akhleif-pixel/fly-brain-drone/docs/drone-3d-revb/pcb-bottom.png

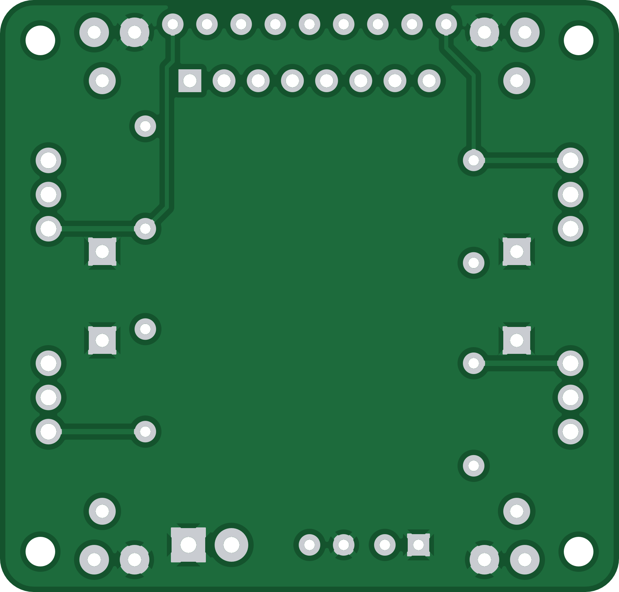
docs/drone-3d-revb/pcb-bottom.png
