akhleif-pixel/fly-brain-drone/docs/drone-3d-revb/pcb-top.png

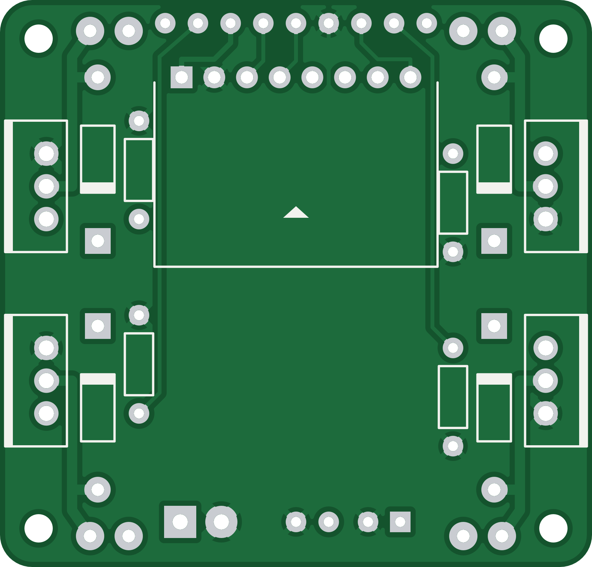
docs/drone-3d-revb/pcb-top.png
