akhleif-pixel/fly-brain-drone/pcb/fc/out/render-angle.png

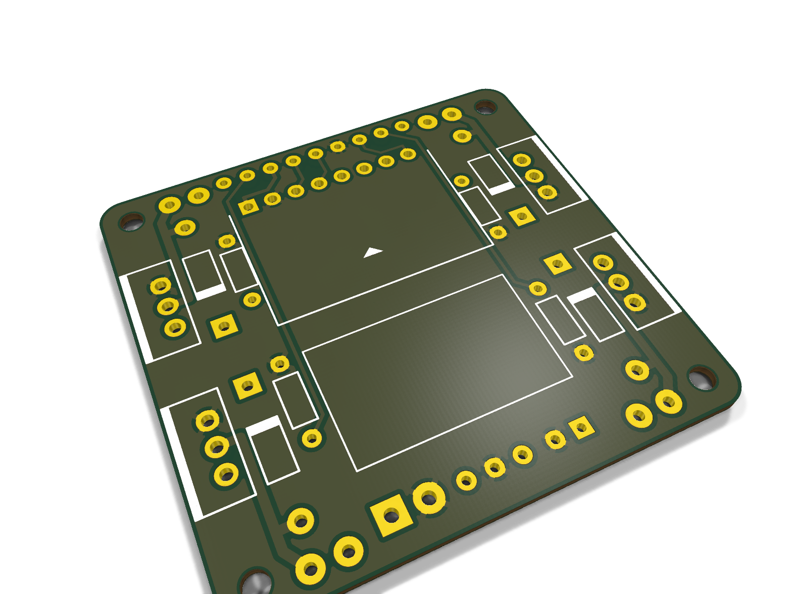
pcb/fc/out/render-angle.png
