akhleif-pixel/fly-brain-drone/pcb/fc/out/render-bottom.png

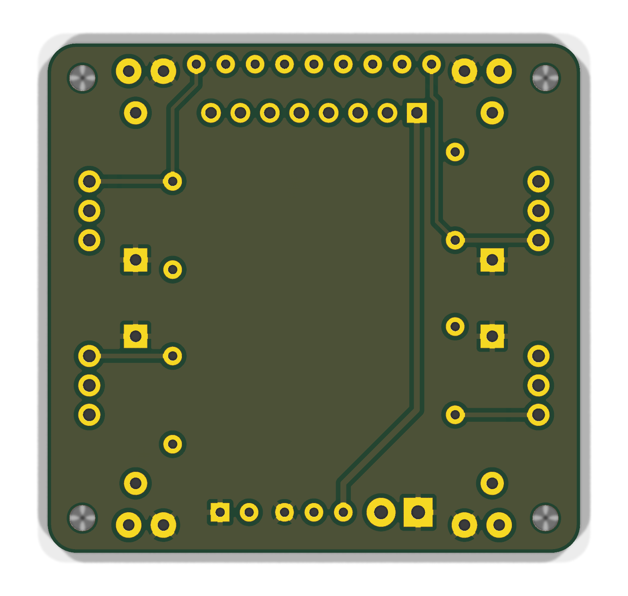
pcb/fc/out/render-bottom.png
