akhleif-pixel/fly-brain-drone/pcb/fc/out/render-top.png

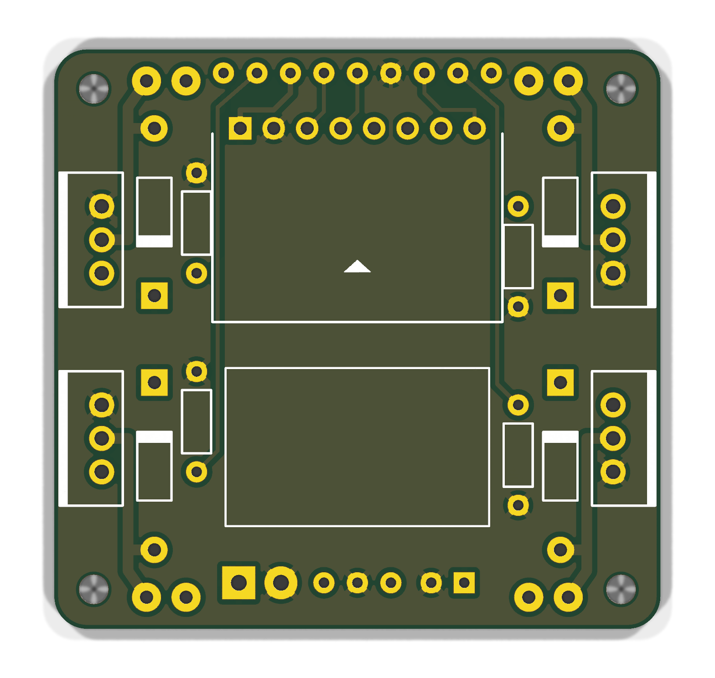
pcb/fc/out/render-top.png
