akhleif-pixel/fly-brain-drone/pcb/out/kicad-render-bottom.png

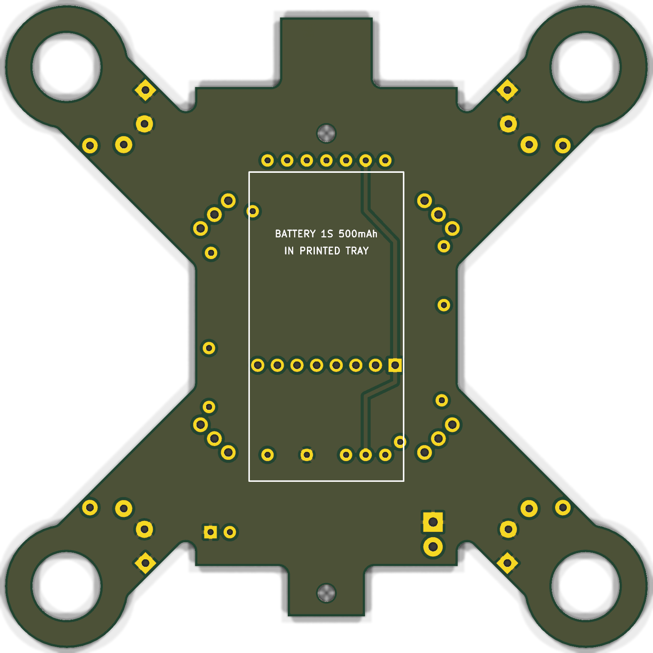
pcb/out/kicad-render-bottom.png
