akhleif-pixel/fly-brain-drone/pcb/out/kicad-render-top.png

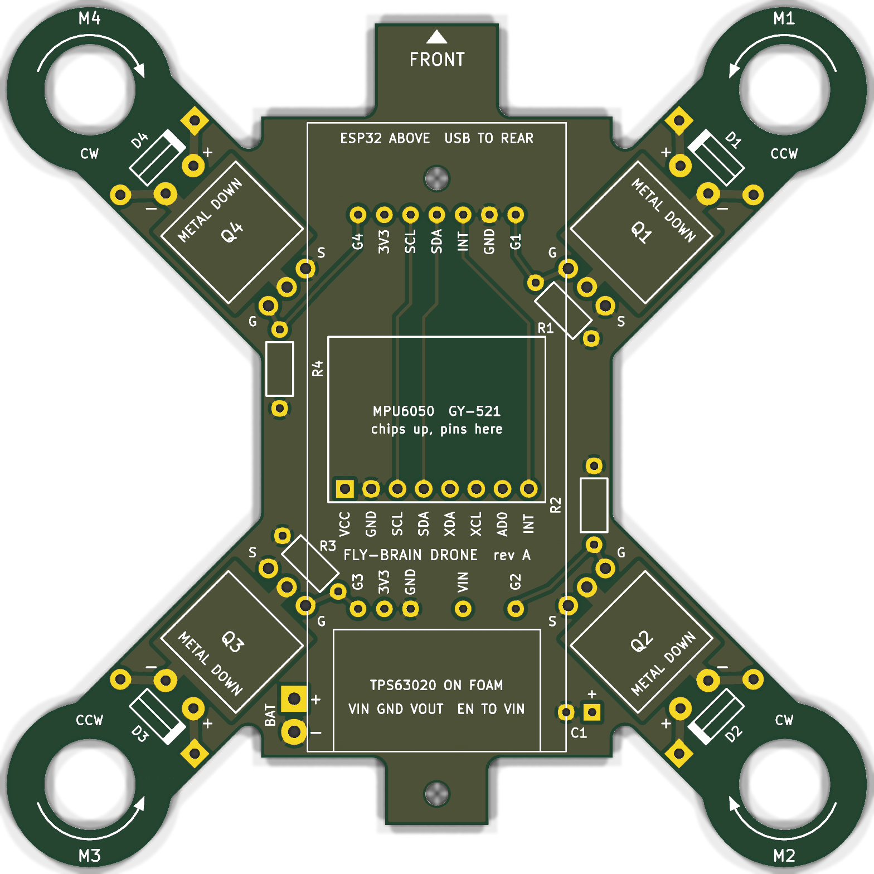
pcb/out/kicad-render-top.png
