akhleif-pixel/fly-brain-drone/pcb/out/preview-bottom.png

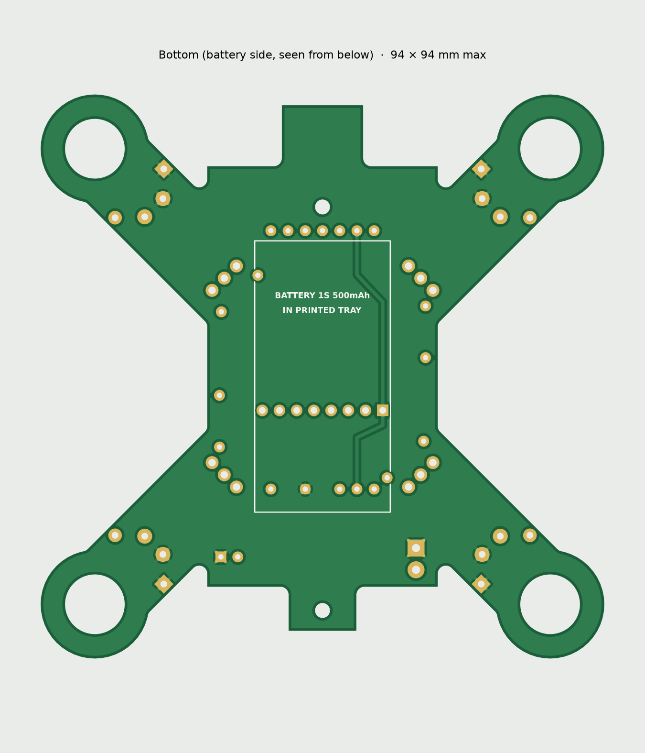
pcb/out/preview-bottom.png
