akhleif-pixel/fly-brain-drone/docs/parts.md

# Parts

AliExpress cart, October 5, 2026: 13 items, $43.31, free shipping, expected October 13–18. Photos and links: https://claude.ai/artifact/14MLLZMBsPiJeyRGL1XqSZ

| Part | Price | Use | Notes |
| --- | --- | --- | --- |
| ESP32-S3 CAM board (N16R8), board only | $6.20 | 1 | Onboard computer |
| OV2640 camera, 66°, 21 mm cable | $4.62 | 1 | The fly's eye |
| GY-521 MPU6050 | $1.82 | 1 | Balance sensor |
| 8520 coreless motors, 2 CW + 2 CCW | $8.74 | 4 | Flight motors |
| 55 mm props + 4 spare 716 motors | $4.06 | 4 props | Spares for bench tests |
| 3.7 V 500 mAh battery | $5.83 | 1 | 3–5 min flight |
| TPS63020 buck-boost, 3.3 V | $1.99 | 1 | Steady 3.3 V |
| 100 µF 16 V capacitors ×20 | $1.85 | 1–2 | Across battery |
| IRLB8721 MOSFETs ×10 | $2.96 | 4 | Motor switches |
| 1N5819 Schottky diodes ×50 | $1.32 | 4 | Flyback protection |
| 10 kΩ resistors ×100 | $1.14 | 4 | Gate pull-downs |
| 28 AWG silicone wire, red, 3 m | $1.43 | ~1 m | |
| Perfboard 4 × 6 cm ×5 | $1.85 | 1 | Motor driver board |

Measured from photos with a ruler (2026-10-26): ESP32 board about 28.5 × 51 mm plus a 7 mm antenna overhang; TPS63020 module about 27.5 × 18.7 mm; IRLB8721 about 10.5 × 16.6 mm (genuine IR); motors about 8.3 × 20 mm; battery about 40 × 24 mm with a small white 2-pin plug.

Already owned: battery charger (check charge current ≤500 mA), 25 V 100 µF capacitors, 1N4002 diodes (bench tests only — too slow for 20 kHz PWM), soldering iron, 3D printing.
