akhleif-pixel/fly-brain-drone/docs/parts-page/img/batt.jpg

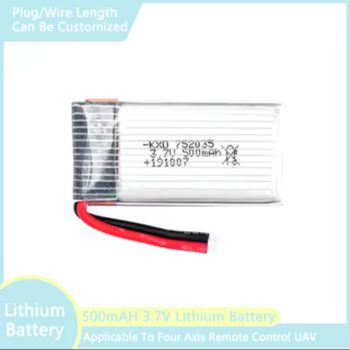
docs/parts-page/img/batt.jpg
