akhleif-pixel/fly-brain-drone/docs/parts-page/img/cam.jpg

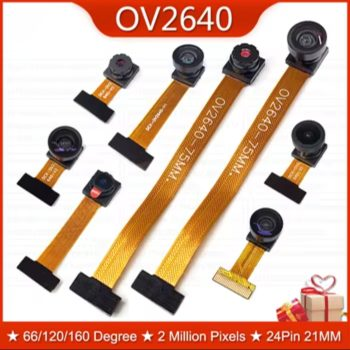
docs/parts-page/img/cam.jpg
