akhleif-pixel/fly-brain-drone/docs/parts-page/img/cap.jpg

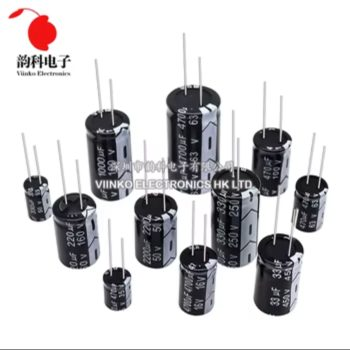
docs/parts-page/img/cap.jpg
