akhleif-pixel/fly-brain-drone/docs/parts-page/img/diode.jpg

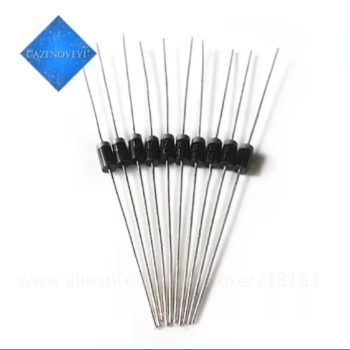
docs/parts-page/img/diode.jpg
