akhleif-pixel/fly-brain-drone/docs/parts-page/img/esp.jpg

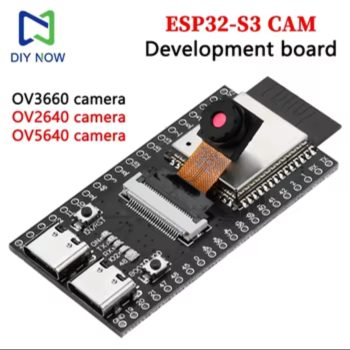
docs/parts-page/img/esp.jpg
