akhleif-pixel/fly-brain-drone/docs/parts-page/img/irlb.jpg

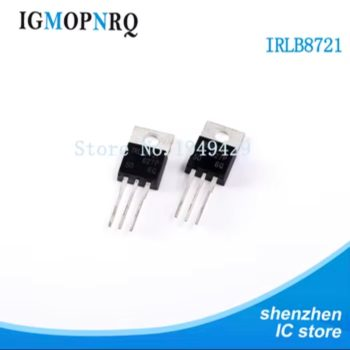
docs/parts-page/img/irlb.jpg
