akhleif-pixel/fly-brain-drone/docs/parts-page/img/m8520.jpg

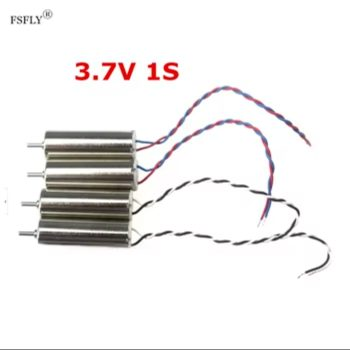
docs/parts-page/img/m8520.jpg
