akhleif-pixel/fly-brain-drone/docs/parts-page/img/mpu.jpg

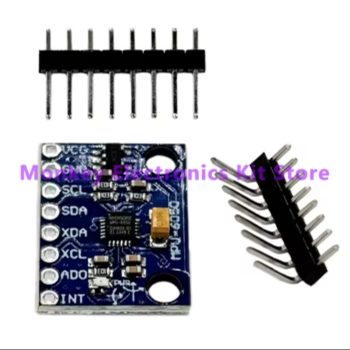
docs/parts-page/img/mpu.jpg
