akhleif-pixel/fly-brain-drone/docs/parts-page/img/perf.jpg

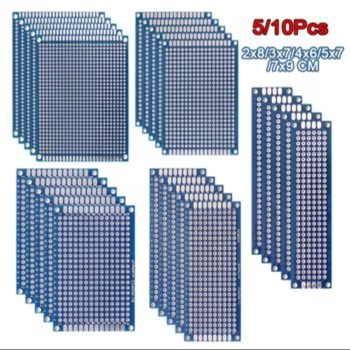
docs/parts-page/img/perf.jpg
