akhleif-pixel/fly-brain-drone/docs/parts-page/img/props.jpg

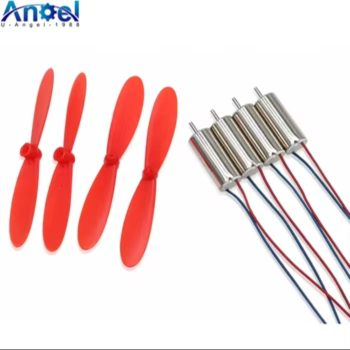
docs/parts-page/img/props.jpg
