akhleif-pixel/fly-brain-drone/docs/parts-page/img/res.jpg

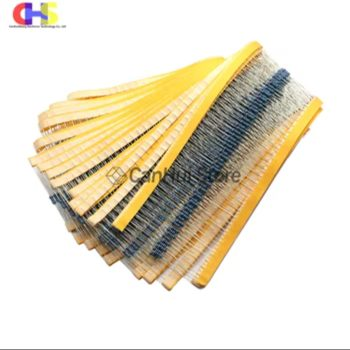
docs/parts-page/img/res.jpg
