akhleif-pixel/fly-brain-drone/docs/parts-page/img/tps.jpg

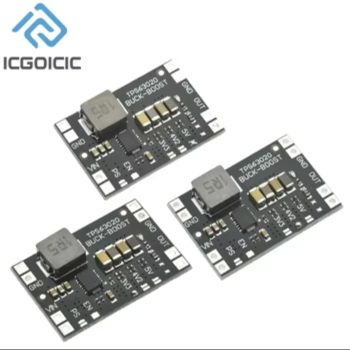
docs/parts-page/img/tps.jpg
