akhleif-pixel/fly-brain-drone/docs/parts-page/img/wire.jpg

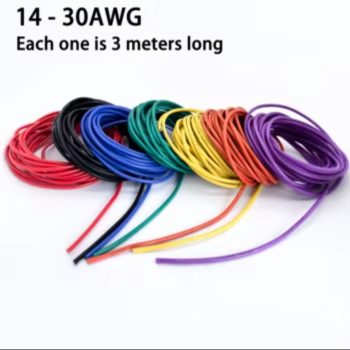
docs/parts-page/img/wire.jpg
