akhleif-pixel/fly-brain-drone/frame/out/frame.stl

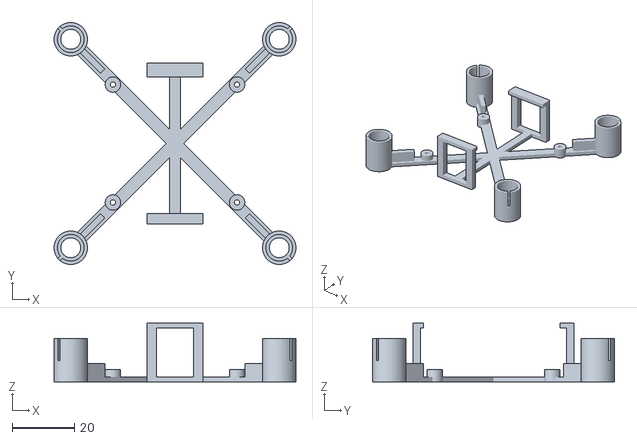
[picture p26: CAD file, 2026-10-27]
frame/out/frame.stl
78.0 x 78.0 x 19.0
