akhleif-pixel/fly-brain-drone/pcb/fc/kicad/fly-fc.kicad_pcb

## KiCad design pcb/fc/kicad/fly-fc.kicad_pcb (2026-10-27)

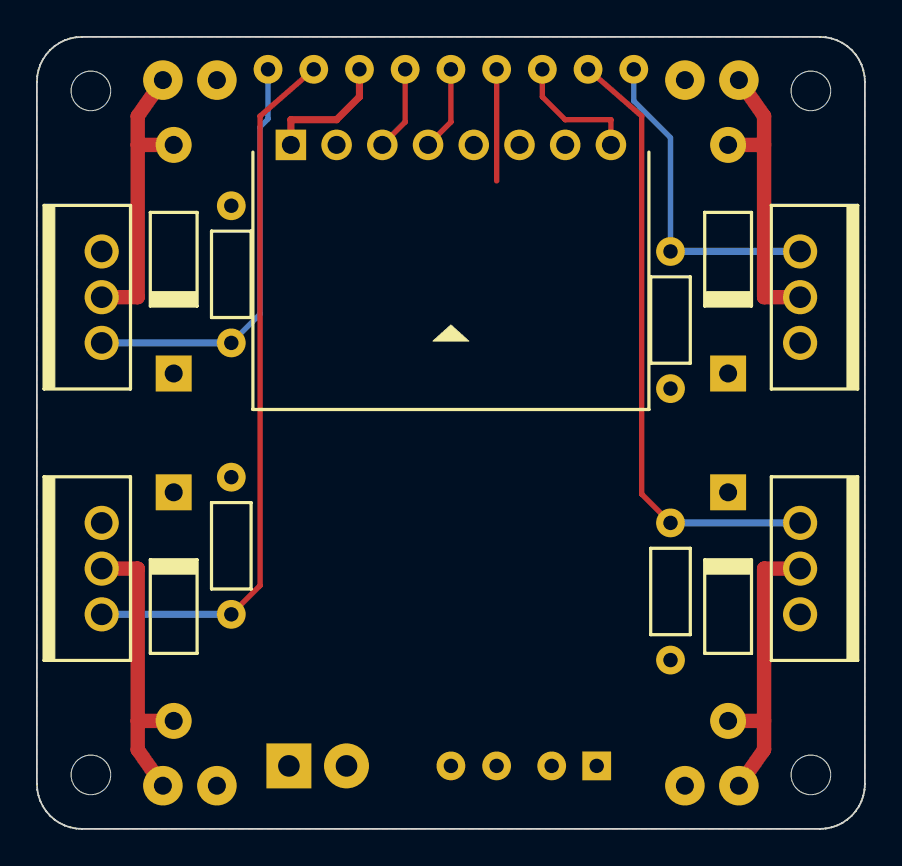
[picture p27: board fly-fc.kicad_pcb from above]

Board: 2 copper layers, 46.0 x 44.0 mm, 34 parts (0 on the bottom side), 14 nets.

Parts:
BAT: battery pigtail; BAT
C1: 100uF; C1
D1: 1N5819; D1
D2: 1N5819; D2
D3: 1N5819; D3
D4: 1N5819; D4
H1, H2, H3, H4: M2; MountingHole_M2
J_3V3: wire pad; J_3V3
J_G1: wire pad; J_G1
J_G2: wire pad; J_G2
J_G3: wire pad; J_G3
J_G4: wire pad; J_G4
J_GND: wire pad; J_GND
J_IN: wire pad; J_IN
J_INT: wire pad; J_INT
J_SCL: wire pad; J_SCL
J_SDA: wire pad; J_SDA
J_TG: wire pad; J_TG
M1: 8520 motor; M1
M2: 8520 motor; M2
M3: 8520 motor; M3
M4: 8520 motor; M4
Q1: IRLB8721; Q1
Q2: IRLB8721; Q2
Q3: IRLB8721; Q3
Q4: IRLB8721; Q4
R1: 10k; R1
R2: 10k; R2
R3: 10k; R3
R4: 10k; R4
U2: GY-521 MPU6050; U2

Connections:
3V3: J_3V3.1, U2.VCC
DRAIN1: D1.A, M1.2, Q1.D
DRAIN2: D2.A, M2.2, Q2.D
DRAIN3: D3.A, M3.2, Q3.D
DRAIN4: D4.A, M4.2, Q4.D
GATE1: J_G1.1, Q1.G, R1.1
GATE2: J_G2.1, Q2.G, R2.1
GATE3: J_G3.1, Q3.G, R3.1
GATE4: J_G4.1, Q4.G, R4.1
GND: BAT.2, C1.2, J_GND.1, J_TG.1, Q1.S, Q2.S, Q3.S, Q4.S, R1.2, R2.2, R3.2, R4.2, U2.GND
INT: J_INT.1, U2.INT
SCL: J_SCL.1, U2.SCL
SDA: J_SDA.1, U2.SDA
VBAT: BAT.1, C1.1, D1.K, D2.K, D3.K, D4.K, J_IN.1, M1.1, M2.1, M3.1, M4.1
