akhleif-pixel/fly-brain-drone/(commit log)

2026-10-08 Start the fly-brain drone project
    Plan, parts list and wiring notes, the 3D build model with its
    step-by-step guide, and the rev A PCB frame generator with Gerbers.
    [bom.csv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]
2026-10-08 Add a KiCad project for the PCB frame
    pcb/kicad/fly-drone.kicad_pro opens in KiCad 8 or newer with real
    footprints, nets, tracks and copper zones. The generator no longer
    overwrites the board once it has been saved in KiCad. Instructions
    for working from KiCad and GitHub Desktop are in the READMEs.
    [fly-drone.kicad_pcb]
2026-10-08 Fix the spin arrows on the front motors
    The arrows on M1 and M4 pointed the opposite way to their CCW/CW labels
    because mirroring the arc for the front motors also reversed its turning
    sense. The generator now measures each arrow's direction and corrects it.
    [fly-drone.kicad_pcb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]
2026-10-25 Make the silkscreen readable for fabrication
    All labels are now at least 0.85 mm tall (JLCPCB's minimum is 0.8 mm),
    motor names no longer sit on their spin arrows, and long labels are
    shortened. KiCad 10 DRC: 0 errors, 0 unconnected items. Copper, drills
    and outline are unchanged. Adds KiCad 3D renders of both sides.
    [fly-drone.kicad_pcb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]
2026-10-26 Record the project status in CLAUDE.md
    Parts arrived, the PCB order is waiting in JLCONE, KiCad DRC results,
    installed tools and open questions, so a new session starts with the
    full picture.
2026-10-26 Add rev B: small flight-controller board for a printed frame
    Ayham didn't want the big X-shaped PCB frame. Rev B is a 46 x 44 mm
    through-hole board that sits in a 3D-printed frame: MOSFETs stand upright
    along the side edges, motor wires come in to corner pads, and the ESP32
    is wired from pads at the front. The silkscreen has no text, because
    Ayham is adding his own labels in KiCad.
    - pcb/fc/gen.py generates Gerbers, previews, BOM and a KiCad project;
    its checks, pcb/fc/_net.py and KiCad 10 DRC all pass.
    - kicad_export.py takes the file name from the generator and now
    refuses to overwrite a board that was saved in KiCad.
    - Rev A is marked as no longer used; CLAUDE.md records the change.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
    [bom.csv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]
2026-10-26 Add a printed frame for the rev B board
    One-piece frame, about 5.6 g in PLA, printed flat with no supports:
    an X with motor clip tubes 95 mm apart across the diagonal, four posts
    for the PCB, two bridges that hold the ESP32 14 mm above the PCB, and
    crossbars for a battery strap underneath.
    frame/gen_frame.py builds it with manifold3d, writes frame/out/frame.stl
    and checks the prop, MOSFET, ESP32 and board-outline clearances.
    frame/render_frame.py renders the frame alone and with the parts in
    Blender.
    [frame.stl]
2026-10-26 Add a 3D model page for rev B
    Interactive model of the current design for Javi: the real printed
    frame mesh, the PCB textured from the generator's copper, mask and
    drills, and every part modelled at its real height. It has an exploded
    view, a 12-step build guide, a rev A to rev B comparison and the pad
    table. Published at https://claude.ai/artifact/K79XjH3TgBpPCP4Wgf5wmB.
    make_assets.py rebuilds the textures and frame mesh after a board or
    frame change.
2026-10-27 Check the parts against the design using Ayham's photos
    - MOSFET holes widened from 1.1 to 1.2 mm so any TO-220 leg fits;
    board checks, netlist and KiCad DRC still pass.
    - ESP32 pin labels match the pin plan. The board is about 28.5 x 51 mm
    (plus antenna) with rows 25.4 mm apart: the frame's bridge tops now
    reach in under its ends, and the 3D model shows the real layout with
    each wire going to its labelled pin.
    - The TPS63020 module is about 27.5 x 18.7 mm and does not fit its
    20 x 12 mm spot on the board; recorded as a blocker before ordering.
    - Measurements recorded in docs/parts.md, docs/wiring.md and the READMEs.
    [fly-fc.kicad_pcb, frame.stl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]
2026-10-27 Move the TPS63020 under the ESP32
    The real module is about 27.5 x 18.7 mm, too big for the 20 x 12 mm spot
    on the board. It now sits on foam under the ESP32 between its pin rows:
    VIN and GND wires go to the rear IN and GND pads, OUT goes straight to
    the ESP32 3V3 pin, which feeds the board through the front 3V3 pad.
    - Board: removed the module outline, the OUT pad and its 3.3 V trace.
    Generator checks, netlist and KiCad DRC pass.
    - Frame: checks that the module clears the MPU6050 (3.7 mm), C1, the
    ESP32 pin rows and the bridge tops; render updated.
    - 3D model, build steps, pad tables, wiring and CLAUDE.md updated.
    [bom.csv, fly-fc.kicad_pcb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]
